johnwinans/2056-LPC546xxJyyyBD208-breakout/README.md

# 2056-LPC546xxJyyyBD208-breakout

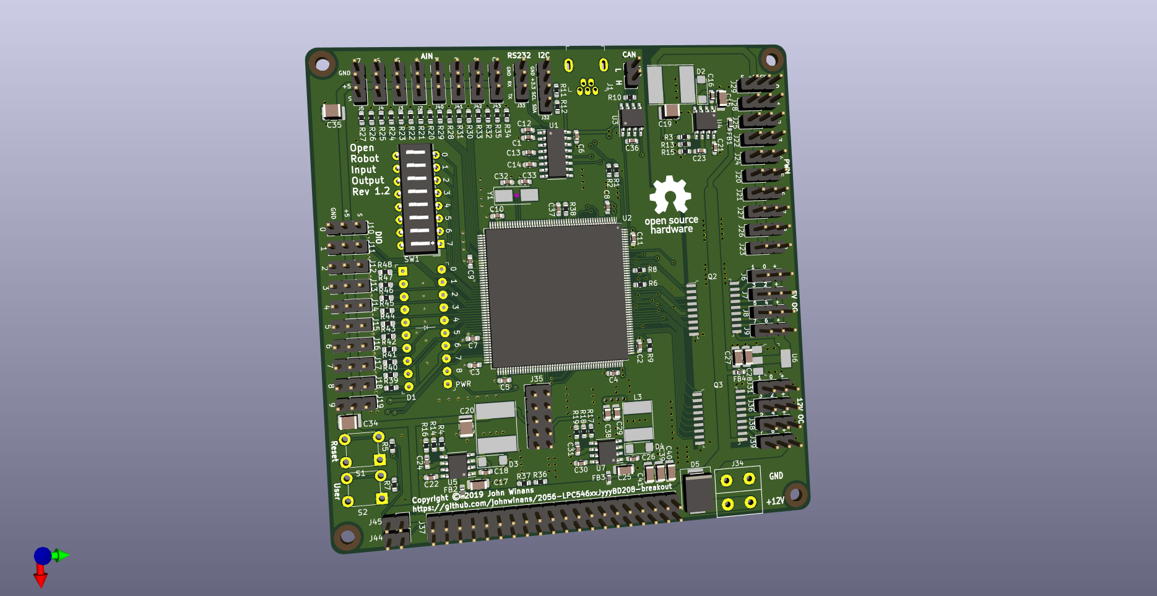
[picture p1: 2056-LPC546xxJyyyBD208-breakout.png]
Front
