johnwinans/2056-LPC546xxJyyyBD208-breakout/2056-LPC546xxJyyyBD208-breakout.pdf

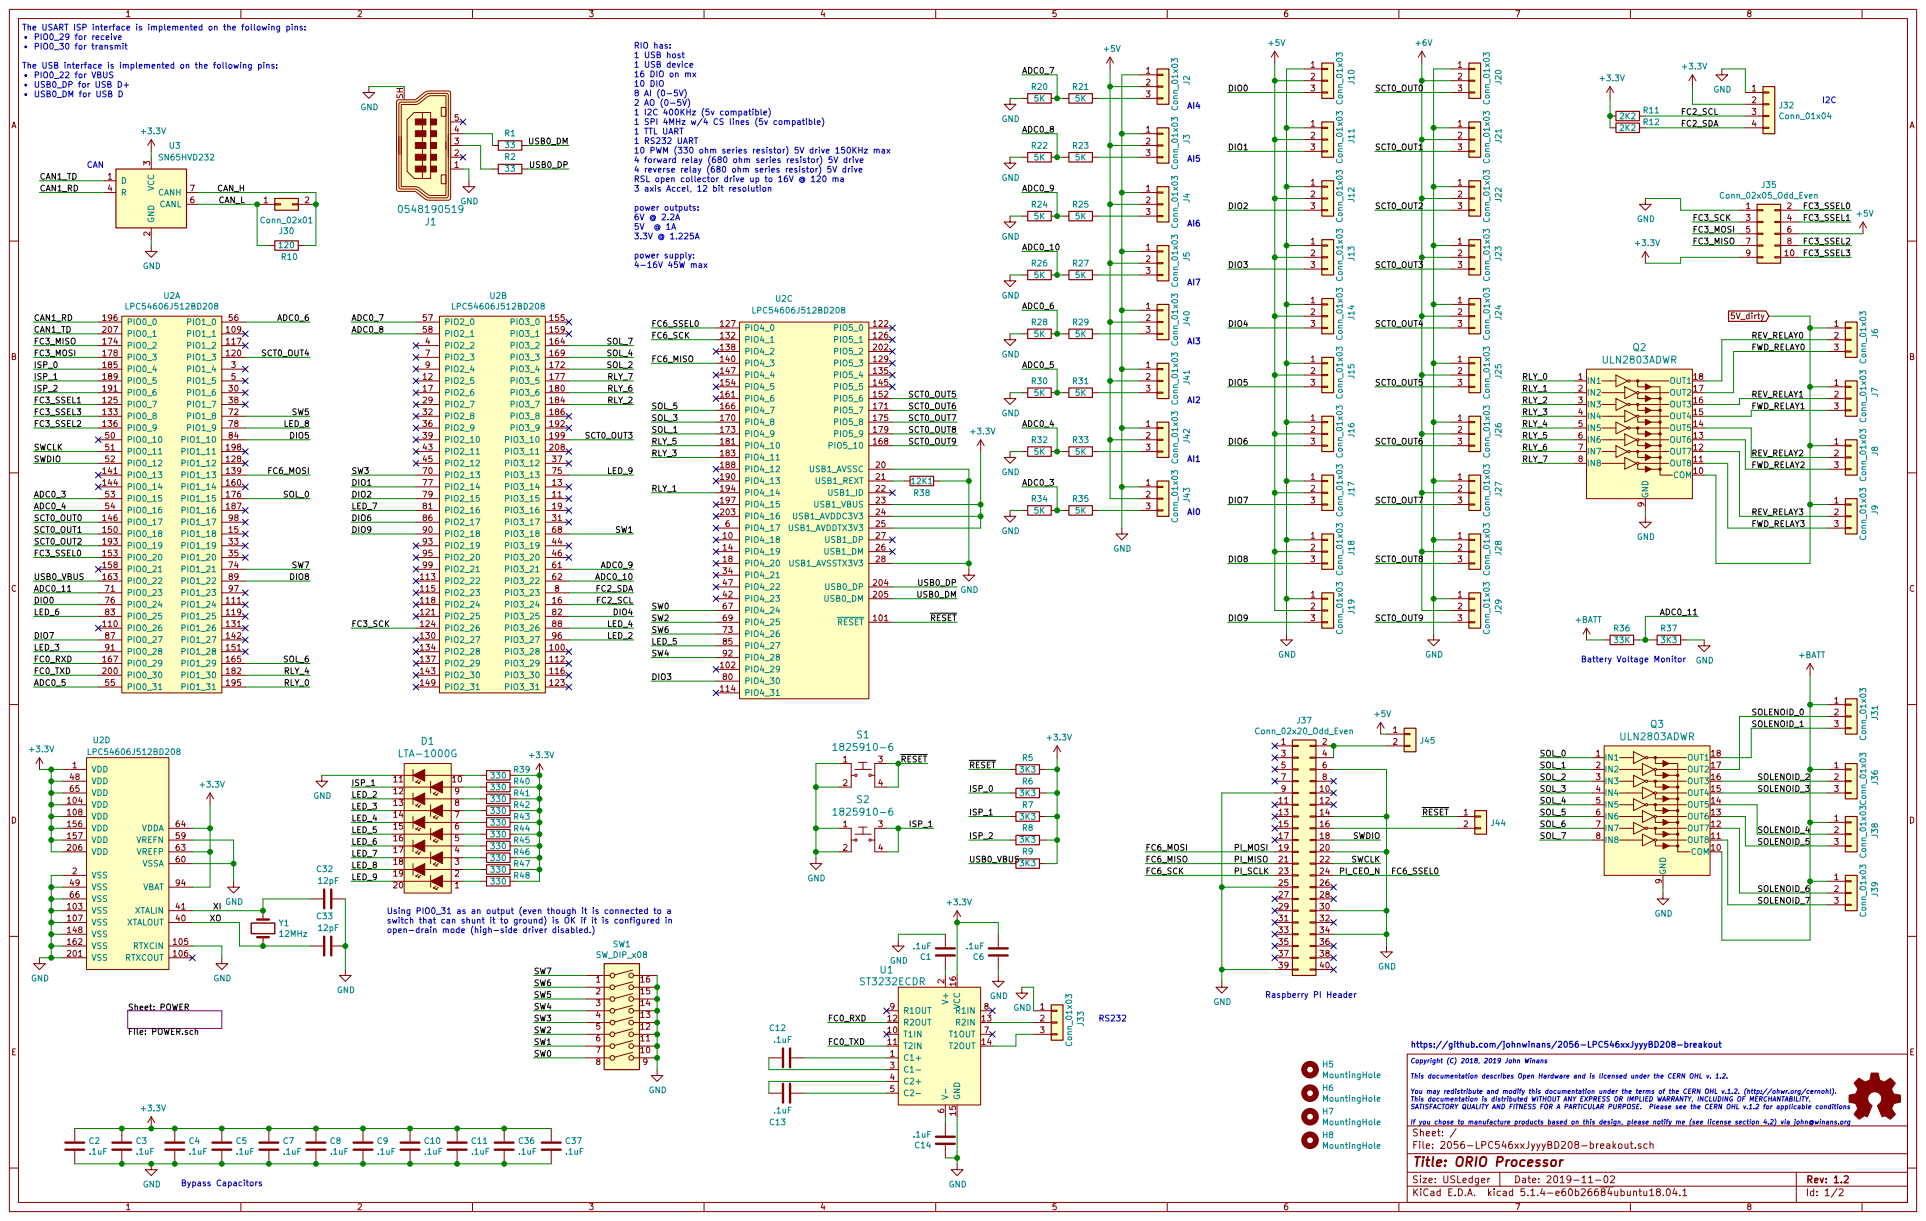
[picture p2: page 1]

The USART ISP interface is implemented on the following pins:
PIO0_29 for receive
PIO0_30 for transmit The USB interface is implemented on the following pins:

RIO has: 1 USB host 1 USB device

16 DIO on mx 10 DIO
1 I2C 400KHz (5v compatible)
1 SPI 4MHz w/4 CS lines (5v compatible) 1 TTL UART

1 RS232 UART
10 PWM (330 ohm series resistor) 5V drive 150KHz max
4 forward relay (680 ohm series resistor) 5V drive
4 reverse relay (680 ohm series resistor) 5V drive
RSL open collector drive up to 16V @ 120 ma
3 axis Accel, 12 bit resolution

Using PIO0_31 as an output (even though it is connected to a
switch that can shunt it to ground) is OK if it is configured in
open-drain mode (high-side driver disabled.)

File: 2056-LPC546xxJyyyBD208-breakout.sch Sheet: / Sheet: POWER

If you chose to manufacture products based on this design, please notify me (see license section 4.2) via john@winans.org https://github.com/johnwinans/2056-LPC546xxJyyyBD208-breakout
Copyright (C) 2018, 2019 John Winans This documentation describes Open Hardware and is licensed under the CERN OHL v. 1.2. You may redistribute and modify this documentation under the terms of the CERN OHL v.1.2. (http://ohwr.org/cernohl). This documentation is distributed WITHOUT ANY EXPRESS OR IMPLIED WARRANTY, INCLUDING OF MERCHANTABILITY, SATISFACTORY QUALITY AND FITNESS FOR A PARTICULAR PURPOSE. Please see the CERN OHL v.1.2 for applicable conditions

Id: 1/2 Title: ORIO Processor

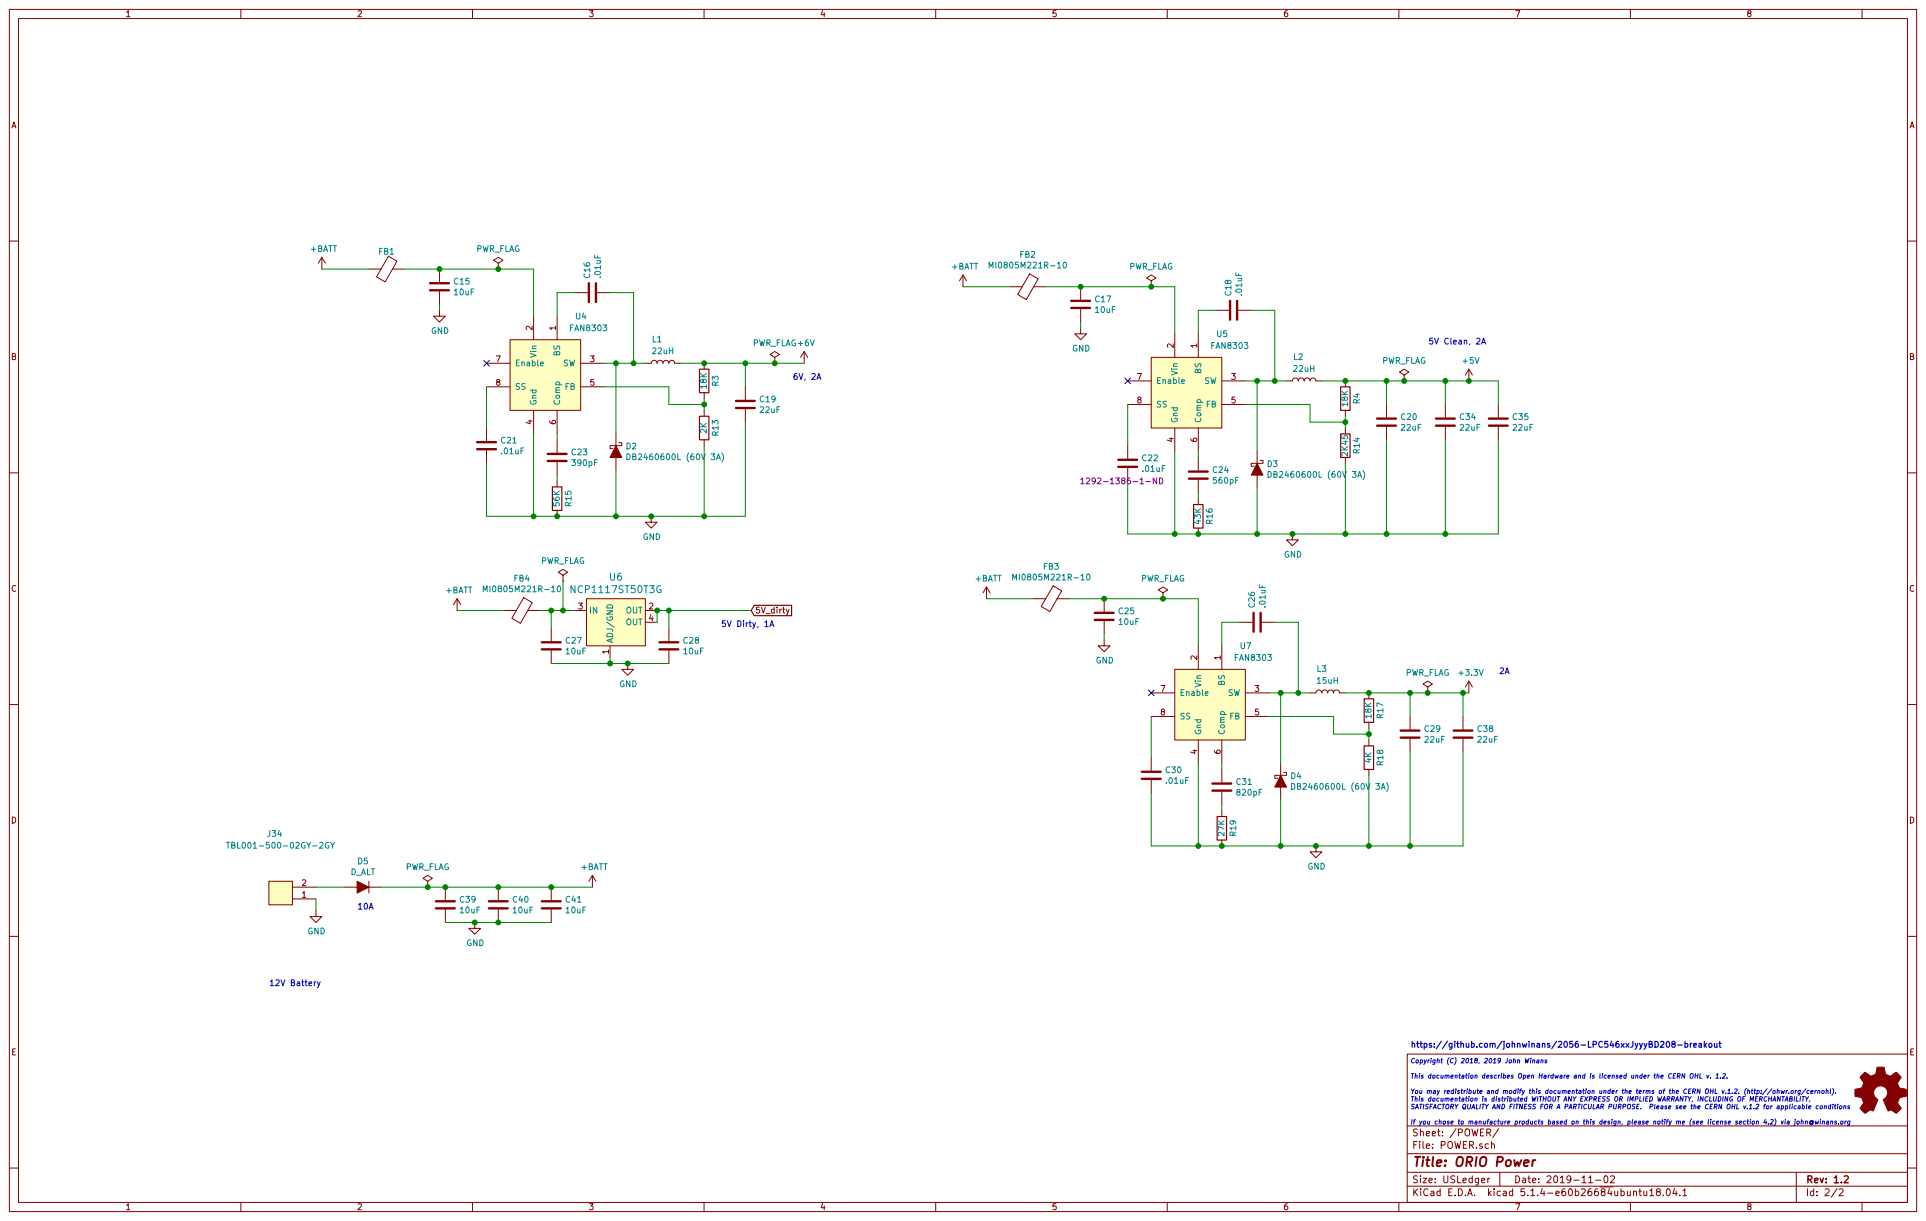
[picture p3: page 2]

If you chose to manufacture products based on this design, please notify me (see license section 4.2) via john@winans.org 10A

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

Id: 2/2 Title: ORIO Power File: POWER.sch Sheet: /POWER/
