johnwinans/2056-LPC546xxJyyyBD208-breakout/2056-LPC546xxJyyyBD208-breakout.kicad_pcb

## KiCad design 2056-LPC546xxJyyyBD208-breakout.kicad_pcb (2019-11-04)

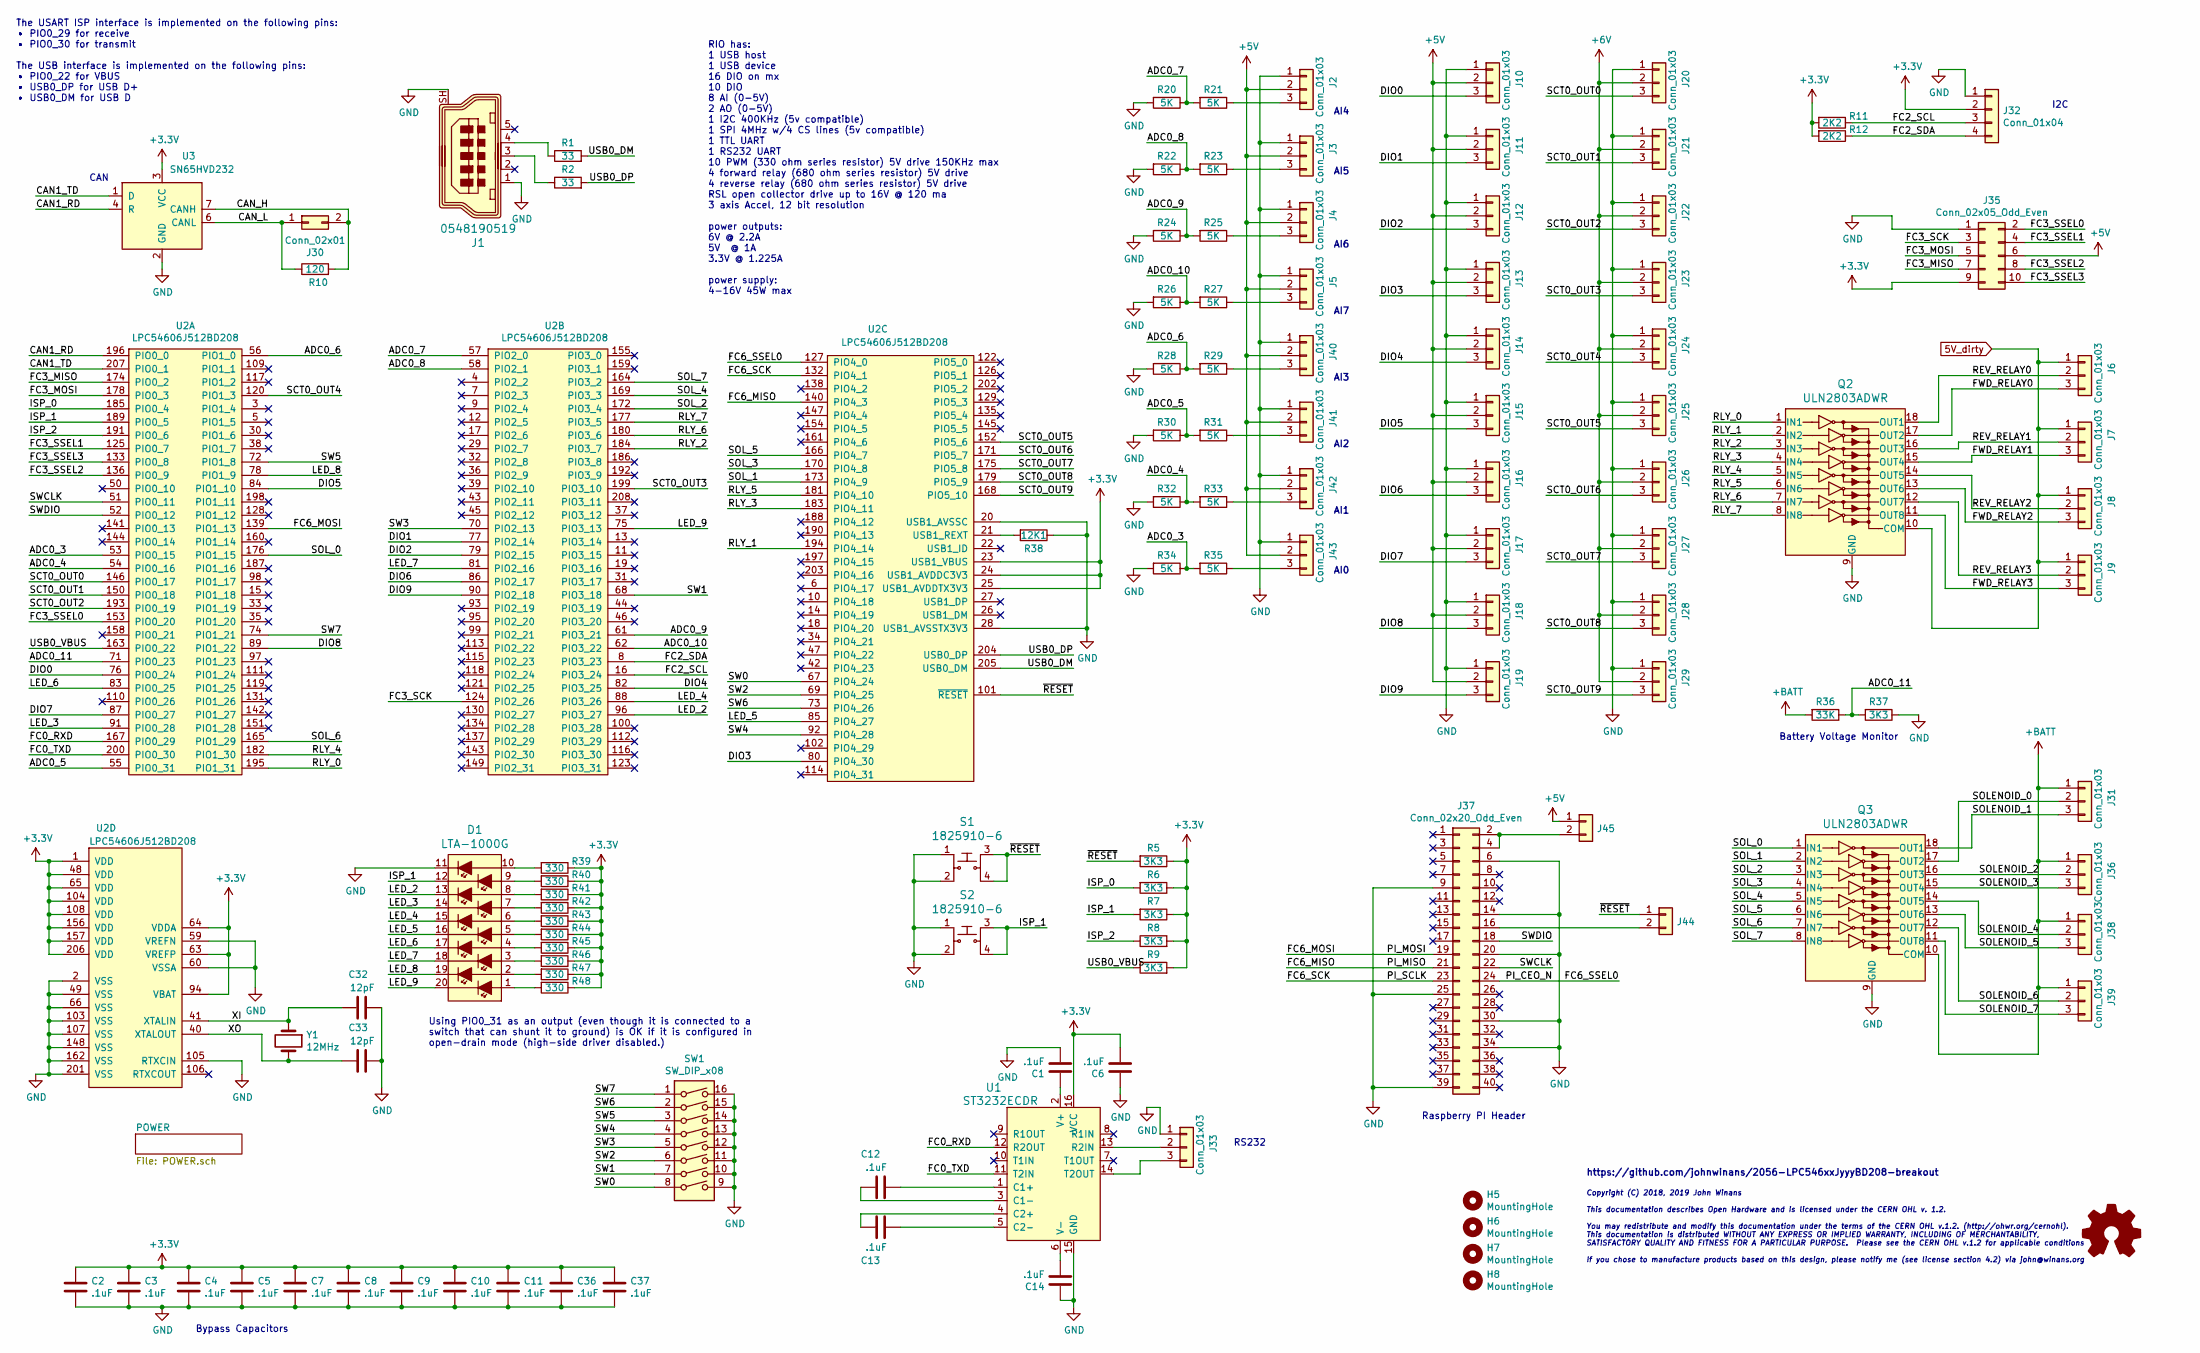
[picture p4: schematic 2056-LPC546xxJyyyBD208-breakout.sch, ORIO Processor]

Parts:
C1, C2, C3, C4, C5, C6, C7, C8, C9, C10, C11, C12, C13, C14, C36, C37: .1uF; C_0603_1608Metric_Pad1.05x0.95mm_HandSolder; Digi-Key_PN 445-6854-1-ND
C32, C33: 12pF; C_0603_1608Metric_Pad1.05x0.95mm_HandSolder; Digi-Key_PN 445-6854-1-ND
D1: LTA-1000G; LED_Bar_Graph_LTA-1000; MPN LTA-1000G; Digi-Key_PN 160-1067-ND
H5, H6, H7, H8: MountingHole; MountingHole_2.7mm_M2.5
J1: 0548190519; USB_Mini_B_Female_548190519; MPN 0548190519; Digi-Key_PN WM17115-ND
J2, J3, J4, J5, J6, J7, J8, J9, J10, J11, J12, J13, J14, J15, J16, J17, J18, J19, J20, J21, J22, J23, J24, J25, J26, J27, J28, J29, J31, J33, J36, J38, J39, J40, J41, J42, J43: Conn_01x03; PinHeader_1x03_P2.54mm_Vertical; Digi-Key_PN 2057-PH1-03-UA-ND
J30: Conn_02x01; PinHeader_1x02_P2.54mm_Vertical; Digi-Key_PN 2057-PH1-02-UA-ND
J32: Conn_01x04; PinHeader_1x04_P2.54mm_Vertical; Digi-Key_PN 2057-PH1-04-UA-ND
J35: Conn_02x05_Odd_Even; PinHeader_2x05_P2.54mm_Vertical
J37: Conn_02x20_Odd_Even; PinHeader_2x20_P2.54mm_Vertical; Digi-Key_PN PH2-20-UA
J44, J45: Conn_01x02; PinHeader_1x02_P2.54mm_Vertical
LOGO1: Logo_Open_Hardware_Small; OSHW-Logo_11.4x12mm_SilkScreen
Q2, Q3: ULN2803ADWR; SOIC-18_W7.5mm; MPN ULN2803ADWR; Digi-Key_PN 296-15777-1-ND
R1, R2: 33; R_0603_1608Metric_Pad1.05x0.95mm_HandSolder; Digi-Key_PN 311-33.0HRCT-ND
R5, R6, R7, R8, R9, R37: 3K3; R_0603_1608Metric_Pad1.05x0.95mm_HandSolder; Digi-Key_PN 311-3.30KHRCT-ND
R10: 120; R_0603_1608Metric_Pad1.05x0.95mm_HandSolder; Digi-Key_PN 311-120HRCT-ND
R11, R12: 2K2; R_0603_1608Metric_Pad1.05x0.95mm_HandSolder; Digi-Key_PN 311-2.20KHRCT-ND
R20, R21, R22, R23, R24, R25, R26, R27, R28, R29, R30, R31, R32, R33, R34, R35: 5K; R_0603_1608Metric_Pad1.05x0.95mm_HandSolder
R36: 33K; R_0603_1608Metric_Pad1.05x0.95mm_HandSolder; Digi-Key_PN 311-33.0KHRCT-ND
R38: 12K1; R_0603_1608Metric_Pad1.05x0.95mm_HandSolder; Digi-Key_PN 311-12.1KHRCT-ND
R39, R40, R41, R42, R43, R44, R45, R46, R47, R48: 330; R_0603_1608Metric_Pad1.05x0.95mm_HandSolder
S1, S2: 1825910-6; Switch_Tactile_THT_6x6mm; MPN 1825910-6; Digi-Key_PN 450-1650-ND
SW1: SW_DIP_x08; SW_DIP_SPSTx08_Slide_6.7x21.88mm_W7.62mm_P2.54mm_LowProfile; Digi-Key_PN CT2108MS-ND
U1: ST3232ECDR; SOIC-16_3.9x9.9mm_P1.27mm; MPN ST3232ECDR; Digi-Key_PN 497-6537-1-ND
U2: LPC54606J512BD208; LQFP-208_28x28mm_P0.5mm; Digi-Key_PN 568-13367-ND
U3: SN65HVD232; SOIC-8_3.9x4.9mm_P1.27mm; Digi-Key_PN 296-26344-1-ND
Y1: 12MHz; Crystal_SMD_5032-2Pin_5.0x3.2mm_HandSoldering; Digi-Key_PN 644-1034-1-ND

Connections:
5V_dirty: J6.1, J7.1, J8.1, J9.1, Q2.10 (COM); also elsewhere on the board
+3V3: C2.1, C3.1, C4.1, C5.1, C6.2, C7.1, C8.1, C9.1, C10.1, C11.1, C36.1, C37.1, J32.2, J35.9, R5.1, R6.1, R7.1, R8.2, R9.2, R11.2, R12.2, R39.1, R40.1, R41.1, R42.1, R43.1, R44.1, R45.1, R46.1, R47.1, R48.1, U1.16 (VCC), U2.1 (VDD), U2.23 (USB1_VBUS), U2.24 (USB1_AVDDC3V3), U2.25 (USB1_AVDDTX3V3), U2.48 (VDD), U2.63 (VREFP), U2.64 (VDDA), U2.65 (VDD), U2.94 (VBAT), U2.104 (VDD), U2.108 (VDD), U2.156 (VDD), U2.157 (VDD), U2.206 (VDD), U3.3 (VCC); also elsewhere on the board
+5V: J2.2, J3.2, J4.2, J5.2, J10.2, J11.2, J12.2, J13.2, J14.2, J15.2, J16.2, J17.2, J18.2, J19.2, J35.6, J40.2, J41.2, J42.2, J43.2, J45.1; also elsewhere on the board
+6V: J20.2, J21.2, J22.2, J23.2, J24.2, J25.2, J26.2, J27.2, J28.2, J29.2; also elsewhere on the board
+BATT: J31.1, J36.1, J38.1, J39.1, Q3.10 (COM), R36.2; also elsewhere on the board
/ADC0_3: R34.1, R35.2, U2.53 (PIO0_15)
/ADC0_4: R32.1, R33.2, U2.54 (PIO0_16)
/ADC0_5: R30.1, R31.2, U2.55 (PIO0_31)
/ADC0_6: R28.1, R29.2, U2.56 (PIO1_0)
/ADC0_7: R20.1, R21.2, U2.57 (PIO2_0)
/ADC0_8: R22.1, R23.2, U2.58 (PIO2_1)
/ADC0_9: R24.1, R25.2, U2.61 (PIO3_21)
/ADC0_10: R26.1, R27.2, U2.62 (PIO3_22)
/ADC0_11: R36.1, R37.2, U2.71 (PIO0_23)
/CAN1_RD: U2.196 (PIO0_0), U3.4 (R)
/CAN1_TD: U2.207 (PIO0_1), U3.1 (D)
/CAN_H: J30.2, R10.2, U3.7 (CANH)
/CAN_L: J30.1, R10.1, U3.6 (CANL)
/DIO0: J10.3, U2.76 (PIO0_24)
/DIO1: J11.3, U2.77 (PIO2_14)
/DIO2: J12.3, U2.79 (PIO2_15)
/DIO3: J13.3, U2.80 (PIO4_30)
/DIO4: J14.3, U2.82 (PIO3_25)
/DIO5: J15.3, U2.84 (PIO1_10)
/DIO6: J16.3, U2.86 (PIO2_17)
/DIO7: J17.3, U2.87 (PIO0_27)
/DIO8: J18.3, U2.89 (PIO1_22)
/DIO9: J19.3, U2.90 (PIO2_18)
/FC0_RXD: U1.12 (R2OUT), U2.167 (PIO0_29)
/FC0_TXD: U1.11 (T2IN), U2.200 (PIO0_30)
/FC2_SCL: J32.3, R11.1, U2.16 (PIO3_24)
/FC2_SDA: J32.4, R12.1, U2.8 (PIO3_23)
/FC3_MISO: J35.7, U2.174 (PIO0_2)
/FC3_MOSI: J35.5, U2.178 (PIO0_3)
/FC3_SCK: J35.3, U2.124 (PIO2_26)
/FC3_SSEL0: J35.2, U2.153 (PIO0_20)
/FC3_SSEL1: J35.4, U2.125 (PIO0_7)
/FC3_SSEL2: J35.8, U2.136 (PIO0_9)
/FC3_SSEL3: J35.10, U2.133 (PIO0_8)
/FC6_MISO: J37.21, U2.140 (PIO4_3)
/FC6_MOSI: J37.19, U2.139 (PIO1_13)
/FC6_SCK: J37.23, U2.132 (PIO4_1)
/FC6_SSEL0: J37.24, U2.127 (PIO4_0)
/FWD_RELAY0: J6.3, Q2.17 (OUT2)
/FWD_RELAY1: J7.3, Q2.15 (OUT4)
/FWD_RELAY2: J8.3, Q2.13 (OUT6)
/FWD_RELAY3: J9.3, Q2.11 (OUT8)
/ISP_0: R6.2, U2.185 (PIO0_4)
/ISP_1: D1.12, R7.2, S2.3, S2.4, U2.189 (PIO0_5)
/ISP_2: R8.1, U2.191 (PIO0_6)
/LED_2: D1.13, U2.96 (PIO3_27)
/LED_3: D1.14, U2.91 (PIO0_28)
/LED_4: D1.15, U2.88 (PIO3_26)
/LED_5: D1.16, U2.85 (PIO4_27)
/LED_6: D1.17, U2.83 (PIO0_25)
/LED_7: D1.18, U2.81 (PIO2_16)
/LED_8: D1.19, U2.78 (PIO1_9)
/LED_9: D1.20, U2.75 (PIO3_13)
/REV_RELAY0: J6.2, Q2.18 (OUT1)
/REV_RELAY1: J7.2, Q2.16 (OUT3)
/REV_RELAY2: J8.2, Q2.14 (OUT5)
/REV_RELAY3: J9.2, Q2.12 (OUT7)
/RLY_0: Q2.1 (IN1), U2.195 (PIO1_31)
/RLY_1: Q2.2 (IN2), U2.194 (PIO4_14)
/RLY_2: Q2.3 (IN3), U2.184 (PIO3_7)
/RLY_3: Q2.4 (IN4), U2.183 (PIO4_11)
/RLY_4: Q2.5 (IN5), U2.182 (PIO1_30)
/RLY_5: Q2.6 (IN6), U2.181 (PIO4_10)
/RLY_6: Q2.7 (IN7), U2.180 (PIO3_6)
/RLY_7: Q2.8 (IN8), U2.177 (PIO3_5)
/SCT0_OUT0: J20.3, U2.146 (PIO0_17)
/SCT0_OUT1: J21.3, U2.150 (PIO0_18)
/SCT0_OUT2: J22.3, U2.193 (PIO0_19)
/SCT0_OUT3: J23.3, U2.199 (PIO3_10)
/SCT0_OUT4: J24.3, U2.120 (PIO1_3)
/SCT0_OUT5: J25.3, U2.152 (PIO5_6)
/SCT0_OUT6: J26.3, U2.171 (PIO5_7)
/SCT0_OUT7: J27.3, U2.175 (PIO5_8)
/SCT0_OUT8: J28.3, U2.179 (PIO5_9)
/SCT0_OUT9: J29.3, U2.168 (PIO5_10)
/SOLENOID_0: J31.2, Q3.17 (OUT2)
/SOLENOID_1: J31.3, Q3.18 (OUT1)
/SOLENOID_2: J36.2, Q3.16 (OUT3)
/SOLENOID_3: J36.3, Q3.15 (OUT4)
/SOLENOID_4: J38.2, Q3.14 (OUT5)
/SOLENOID_5: J38.3, Q3.13 (OUT6)
/SOLENOID_6: J39.2, Q3.12 (OUT7)
/SOLENOID_7: J39.3, Q3.11 (OUT8)
/SOL_0: Q3.1 (IN1), U2.176 (PIO1_15)
/SOL_1: Q3.2 (IN2), U2.173 (PIO4_9)
/SOL_2: Q3.3 (IN3), U2.172 (PIO3_4)
/SOL_3: Q3.4 (IN4), U2.170 (PIO4_8)
/SOL_4: Q3.5 (IN5), U2.169 (PIO3_3)
/SOL_5: Q3.6 (IN6), U2.166 (PIO4_7)
/SOL_6: Q3.7 (IN7), U2.165 (PIO1_29)
/SOL_7: Q3.8 (IN8), U2.164 (PIO3_2)
/SW0: SW1.8, U2.67 (PIO4_24)
/SW1: SW1.7, U2.68 (PIO3_18)
/SW2: SW1.6, U2.69 (PIO4_25)
/SW3: SW1.5, U2.70 (PIO2_13)
/SW4: SW1.4, U2.92 (PIO4_28)
/SW5: SW1.3, U2.72 (PIO1_8)
/SW6: SW1.2, U2.73 (PIO4_26)
/SW7: SW1.1, U2.74 (PIO1_21)
/SWCLK: J37.22, U2.51 (PIO0_11)
/SWDIO: J37.18, U2.52 (PIO0_12)
/USB0_DM: R1.2, U2.205 (USB0_DM)
/USB0_DP: R2.2, U2.204 (USB0_DP)
/USB0_VBUS: R9.1, U2.163 (PIO0_22)
/XI: C32.1, U2.41 (XTALIN), Y1.1
/XO: C33.1, U2.40 (XTALOUT), Y1.2
/~RESET~: J44.1, R5.2, S1.3, S1.4, U2.101 (~RESET)
GND: C1.2, C2.2, C3.2, C4.2, C5.2, C6.1, C7.2, C8.2, C9.2, C10.2, C11.2, C14.1, C32.2, C33.2, C36.2, C37.2, D1.11, J1.1, J1.SH, J2.1, J3.1, J4.1, J5.1, J10.1, J11.1, J12.1, J13.1, J14.1, J15.1, J16.1, J17.1, J18.1, J19.1, J20.1, J21.1, J22.1, J23.1, J24.1, J25.1, J26.1, J27.1, J28.1, J29.1, J32.1, J33.1, J35.1, J37.6, J37.9, J37.14, J37.20, J37.25, J37.30, J37.34, J37.39, J40.1, J41.1, J42.1, J43.1, Q2.9 (GND), Q3.9 (GND), R20.2, R22.2, R24.2, R26.2, R28.2, R30.2, R32.2, R34.2, R37.1, R38.1, S1.1, S1.2, S2.1, S2.2, SW1.9, SW1.10, SW1.11, SW1.12, SW1.13, SW1.14, SW1.15, SW1.16, U1.15 (GND), U2.2 (VSS), U2.20 (USB1_AVSSC), U2.28 (USB1_AVSSTX3V3), U2.49 (VSS), U2.59 (VREFN), U2.60 (VSSA), U2.66 (VSS), U2.103 (VSS), U2.105 (RTXCIN), U2.107 (VSS), U2.148 (VSS), U2.162 (VSS), U2.201 (VSS), U3.2 (GND); also elsewhere on the board
unnamed: C1.1, U1.2 (V+)
unnamed: C12.1, U1.3 (C1-)
unnamed: C12.2, U1.1 (C1+)
unnamed: C13.1, U1.4 (C2+)
unnamed: C13.2, U1.5 (C2-)
unnamed: C14.2, U1.6 (V-)
unnamed: D1.1, R48.2
unnamed: D1.2, R47.2
unnamed: D1.3, R46.2
unnamed: D1.4, R45.2
unnamed: D1.5, R44.2
unnamed: D1.6, R43.2
unnamed: D1.7, R42.2
unnamed: D1.8, R41.2
unnamed: D1.9, R40.2
unnamed: D1.10, R39.2
unnamed: J1.3, R2.1
unnamed: J1.4, R1.1
unnamed: J2.3, R21.1
unnamed: J3.3, R23.1
unnamed: J4.3, R25.1
unnamed: J5.3, R27.1
unnamed: J33.2, U1.13 (R2IN)
unnamed: J33.3, U1.14 (T2OUT)
unnamed: J37.2, J37.4, J45.2
unnamed: J37.16, J44.2
unnamed: J40.3, R29.1
unnamed: J41.3, R31.1
unnamed: J42.3, R33.1
unnamed: J43.3, R35.1
unnamed: R38.2, U2.21 (USB1_REXT)

Notes on the sheet:
Bypass Capacitors
Copyright (C) 2018, 2019 John Winans This documentation describes Open Hardware and is licensed under the CERN OHL v. 1.2. You may redistribute and modify this documentation under the terms of the CERN OHL v.1.2. (http://ohwr.org/cernohl). This documentation is distributed WITHOUT ANY EXPRESS OR IM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
The USART ISP interface is implemented on the following pins: • PIO0_29 for receive • PIO0_30 for transmit The USB interface is implemented on the following pins: • PIO0_22 for VBUS • USB0_DP for USB D+ • USB0_DM for USB D
https://github.com/johnwinans/2056-LPC546xxJyyyBD208-breakout
RIO has: 1 USB host 1 USB device 16 DIO on mx 10 DIO 8 AI (0-5V) 2 AO (0-5V) 1 I2C 400KHz (5v compatible) 1 SPI 4MHz w/4 CS lines (5v compatible) 1 TTL UART 1 RS232 UART 10 PWM (330 ohm series resistor) 5V drive 150KHz max 4 forward relay (680 ohm series resistor) 5V drive 4 reverse relay (680 ohm 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
I2C
CAN
Using PIO0_31 as an output (even though it is connected to a switch that can shunt it to ground) is OK if it is configured in open-drain mode (high-side driver disabled.)
Raspberry PI Header
RS232
Battery Voltage Monitor
AI0
AI1
AI2
AI3
AI7
AI6
AI5
AI4

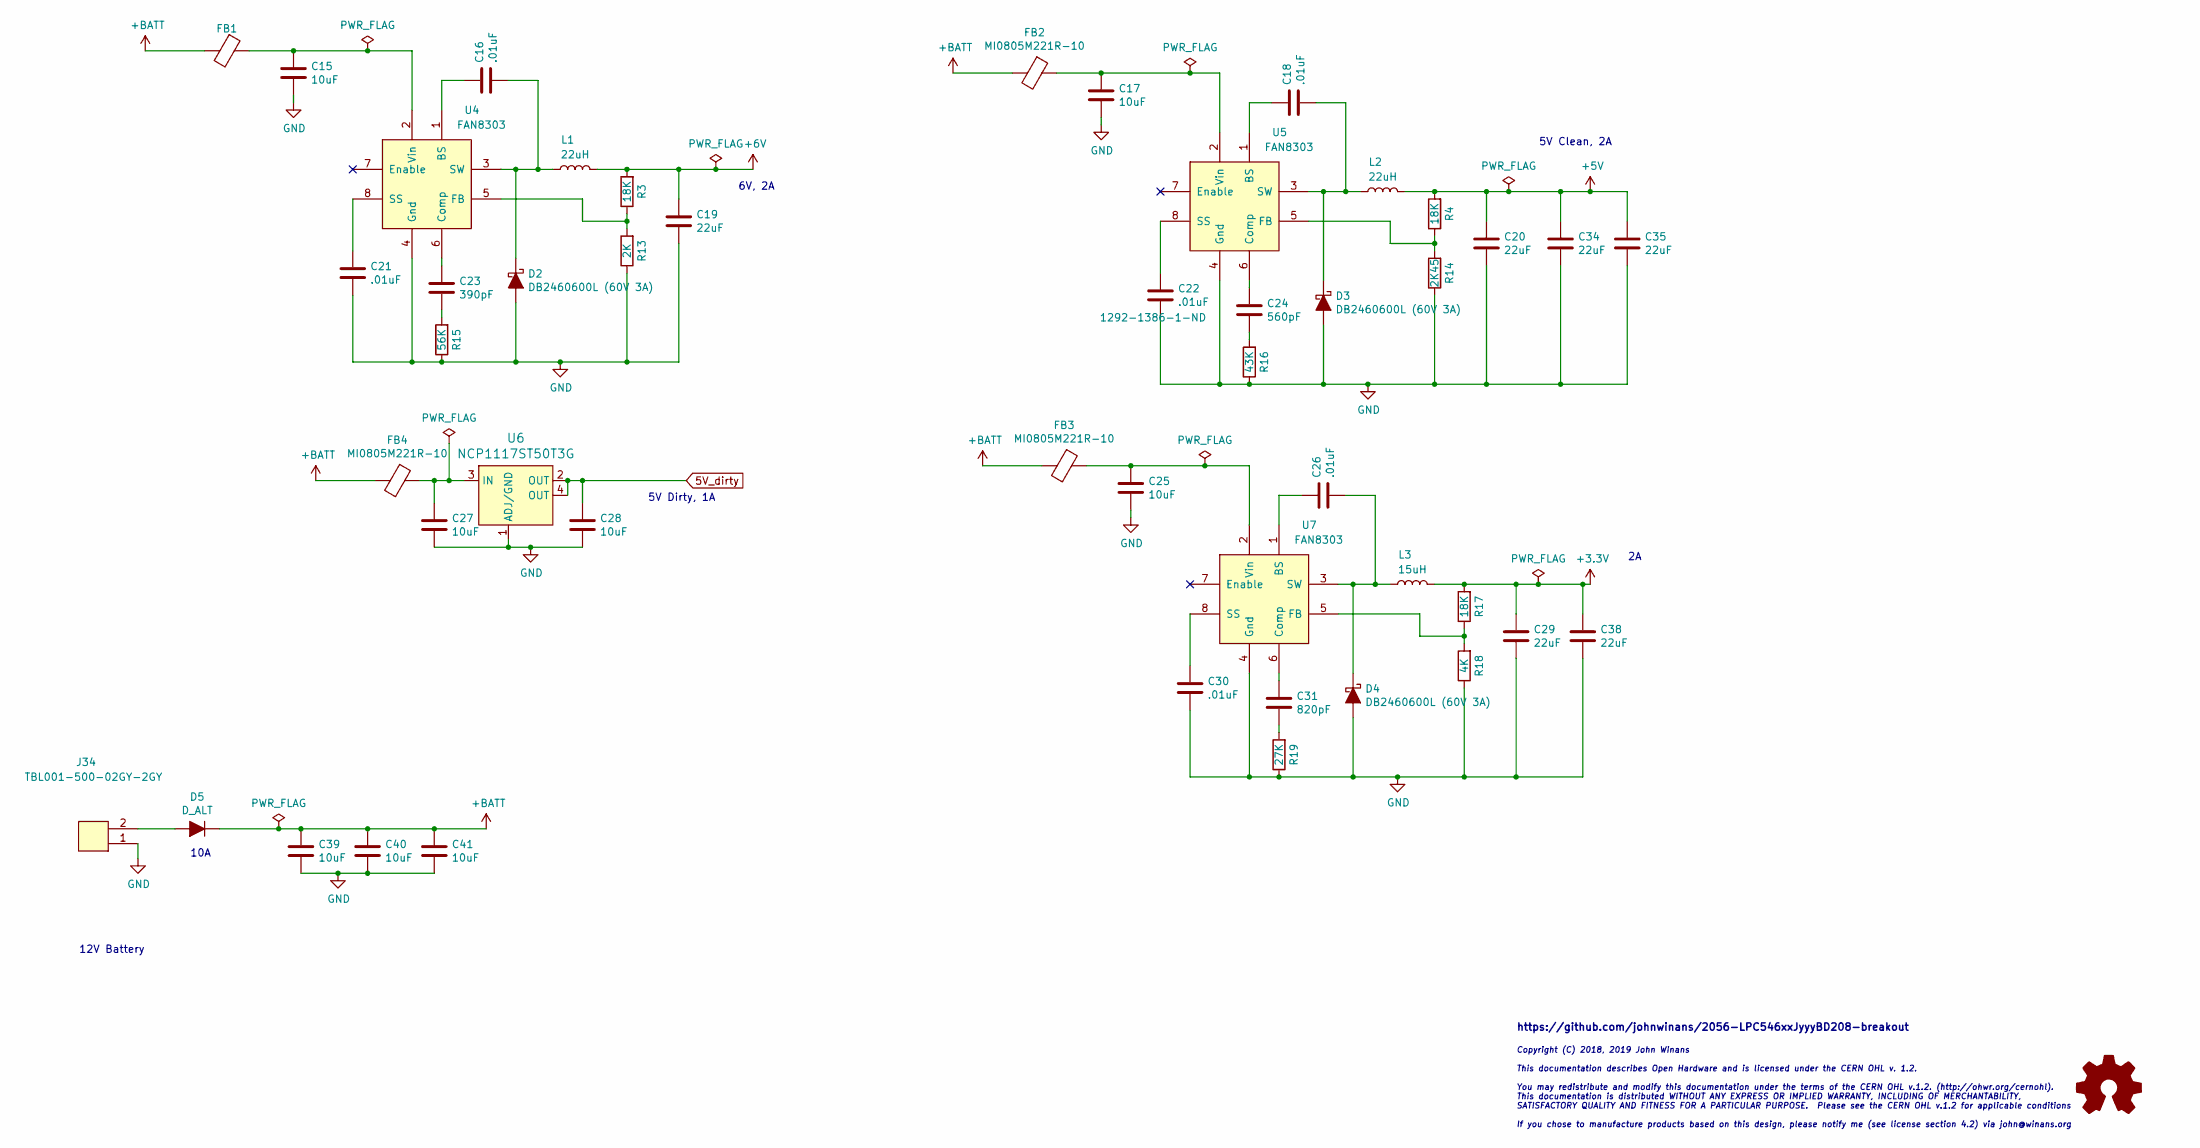
[picture p5: schematic POWER.sch, ORIO Power]

Parts:
C15, C17, C25, C27, C28, C39, C40, C41: 10uF; C_1206_3216Metric_Pad1.42x1.75mm_HandSolder; Digi-Key_PN 1276-1075-1-ND
C16, C18, C21, C22, C26, C30: .01uF; C_0603_1608Metric_Pad1.05x0.95mm_HandSolder; Digi-Key_PN 1292-1386-1-ND
C19, C20, C34, C35: 22uF; C_1210_3225Metric_Pad1.42x2.65mm_HandSolder; Digi-Key_PN 1276-6780-1-ND
C23: 390pF; C_0603_1608Metric_Pad1.05x0.95mm_HandSolder; Digi-Key_PN 1276-2049-1-ND
C24: 560pF; C_0603_1608Metric_Pad1.05x0.95mm_HandSolder; Digi-Key_PN 1276-1278-1-ND
C29, C38: 22uF; C_0805_2012Metric_Pad1.15x1.40mm_HandSolder; Digi-Key_PN 1276-6780-1-ND
C31: 820pF; C_0603_1608Metric_Pad1.05x0.95mm_HandSolder; Digi-Key_PN 1276-2117-1-ND
D2, D3, D4: DB2460600L (60V 3A); D_1806_4516Metric_Pad1.57x1.80mm_HandSolder; Digi-Key_PN DB2460600LCT-ND
D5: D_ALT; D_SMC; Digi-Key_PN S10KCV7GCT-ND
FB1, FB2, FB3, FB4: MI0805M221R-10; L_0603_1608Metric_Pad1.05x0.95mm_HandSolder; Digi-Key_PN 240-2392-1-ND
J34: TBL001-500-02GY-2GY; Digi-Key_PN 102-6360-ND
L1, L2: 22uH; L_Taiyo-Yuden_NR-80xx_HandSoldering; MPN NR8040T220M; Digi-Key_PN 587-2002-1-ND
L3: 15uH; L_Taiyo-Yuden_NR-60xx_HandSoldering; Digi-Key_PN 587-2633-1-ND
R3, R4, R17: 18K; R_0603_1608Metric_Pad1.05x0.95mm_HandSolder; Digi-Key_PN 311-18.0KHRCT-ND
R13: 2K; R_0603_1608Metric_Pad1.05x0.95mm_HandSolder
R14: 2K45; R_0603_1608Metric_Pad1.05x0.95mm_HandSolder; Digi-Key_PN 311-2.43KHRCT-ND
R15: 56K; R_0603_1608Metric_Pad1.05x0.95mm_HandSolder; Digi-Key_PN CR0603-JW-563ELFCT-ND
R16: 43K; R_0603_1608Metric_Pad1.05x0.95mm_HandSolder; Digi-Key_PN 311-43.0KHRCT-ND
R18: 4K; R_0603_1608Metric_Pad1.05x0.95mm_HandSolder; Digi-Key_PN 311-4.02KHRCT-ND
R19: 27K; R_0603_1608Metric_Pad1.05x0.95mm_HandSolder; Digi-Key_PN 311-27.0KHRCT-ND
U4, U5, U7: FAN8303; SOIC-8_3.9x4.9mm_P1.27mm; Digi-Key_PN FAN8303MXCT-ND
U6: NCP1117ST50T3G; SOT-223; MPN NCP1117ST50T3G; Digi-Key_PN NCP1117ST50T3GOSCT-ND

Connections:
5V_dirty: C28.1, U6.2 (OUT), U6.4 (OUT); also elsewhere on the board
+3V3: C29.1, C38.1, L3.2, R17.2; also elsewhere on the board
+5V: C20.1, C34.1, C35.1, L2.2, R4.2; also elsewhere on the board
+6V: C19.1, L1.2, R3.2; also elsewhere on the board
+BATT: C39.1, C40.1, C41.1, D5.1 (K), FB1.2, FB2.2, FB3.2, FB4.2; also elsewhere on the board
GND: C15.2, C17.2, C19.2, C20.2, C21.2, C22.2, C25.2, C27.2, C28.2, C29.2, C30.2, C34.2, C35.2, C38.2, C39.2, C40.2, C41.2, D2.2 (A), D3.2 (A), D4.2 (A), J34.1, R13.1, R14.1, R15.1, R16.1, R18.1, R19.1, U4.4 (Gnd), U5.4 (Gnd), U6.1 (ADJ/GND), U7.4 (Gnd); also elsewhere on the board
unnamed: C15.1, FB1.1, U4.2 (Vin)
unnamed: C16.1, U4.1 (BS)
unnamed: C16.2, D2.1 (K), L1.1, U4.3 (SW)
unnamed: C17.1, FB2.1, U5.2 (Vin)
unnamed: C18.1, U5.1 (BS)
unnamed: C18.2, D3.1 (K), L2.1, U5.3 (SW)
unnamed: C21.1, U4.8 (SS)
unnamed: C22.1, U5.8 (SS)
unnamed: C23.1, U4.6 (Comp)
unnamed: C23.2, R15.2
unnamed: C24.1, U5.6 (Comp)
unnamed: C24.2, R16.2
unnamed: C25.1, FB3.1, U7.2 (Vin)
unnamed: C26.1, U7.1 (BS)
unnamed: C26.2, D4.1 (K), L3.1, U7.3 (SW)
unnamed: C27.1, FB4.1, U6.3 (IN)
unnamed: C30.1, U7.8 (SS)
unnamed: C31.1, U7.6 (Comp)
unnamed: C31.2, R19.2
unnamed: D5.2 (A), J34.2
unnamed: R3.1, R13.2, U4.5 (FB)
unnamed: R4.1, R14.2, U5.5 (FB)
unnamed: R17.1, R18.2, U7.5 (FB)

Notes on the sheet:
5V Clean, 2A
6V, 2A
5V Dirty, 1A
Copyright (C) 2018, 2019 John Winans This documentation describes Open Hardware and is licensed under the CERN OHL v. 1.2. You may redistribute and modify this documentation under the terms of the CERN OHL v.1.2. (http://ohwr.org/cernohl). This documentation is distributed WITHOUT ANY EXPRESS OR IM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
https://github.com/johnwinans/2056-LPC546xxJyyyBD208-breakout
12V Battery
10A

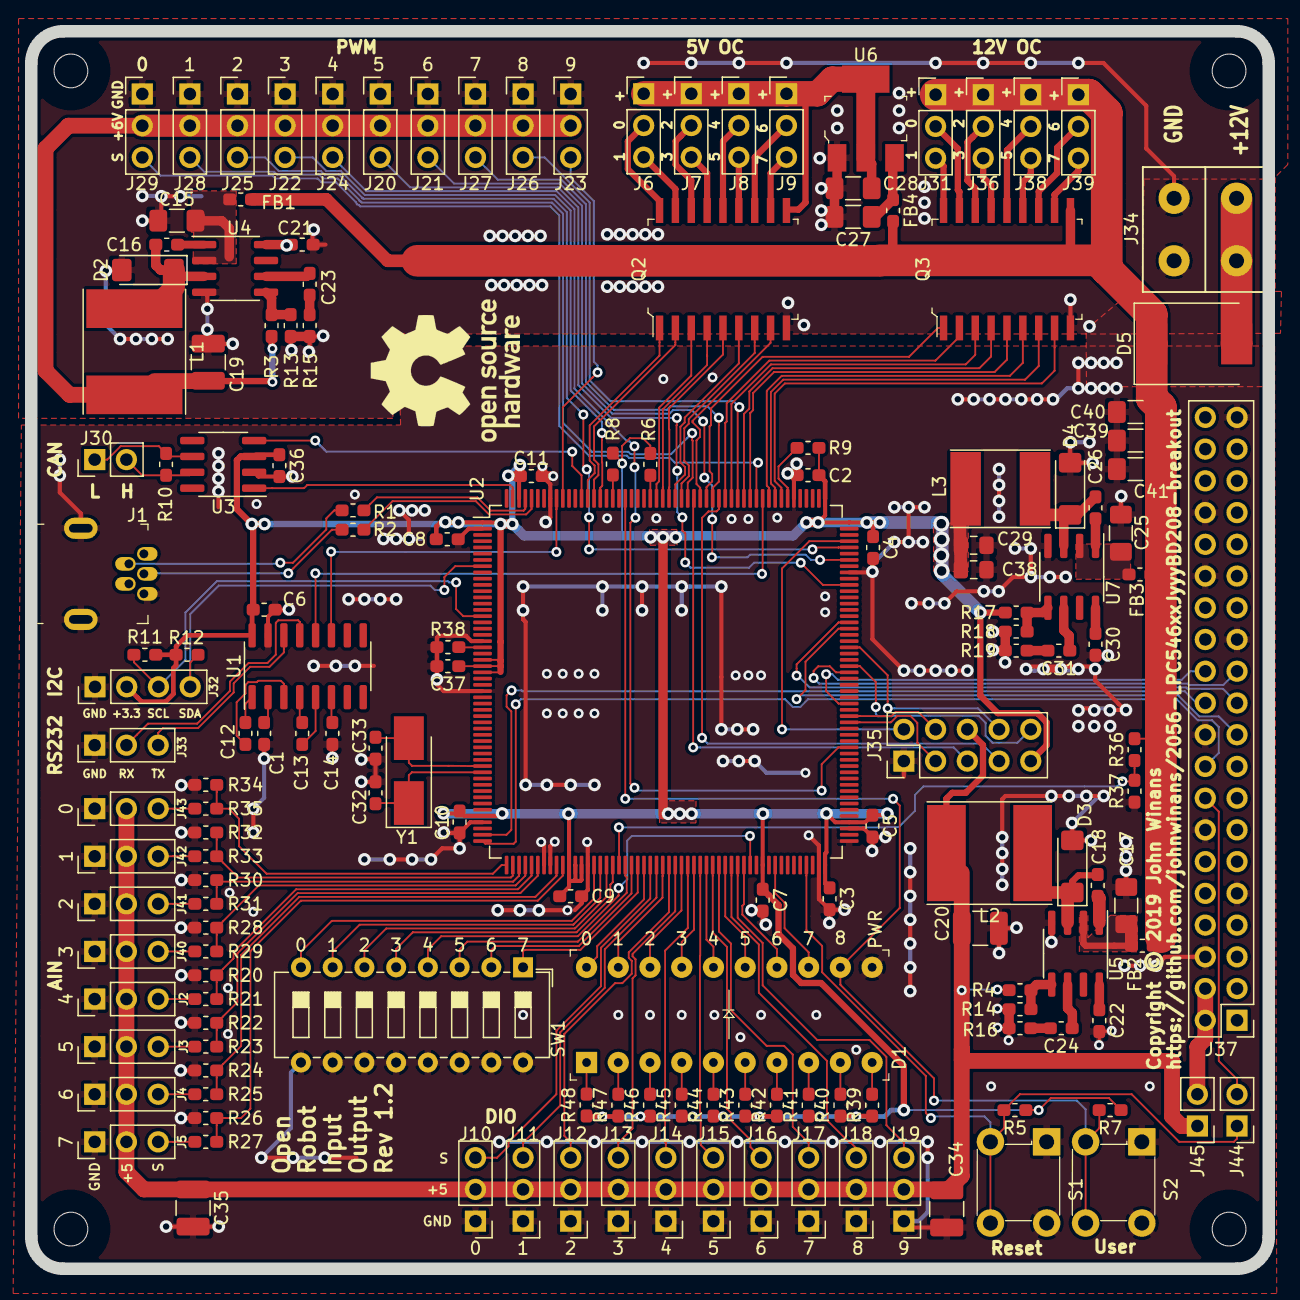
[picture p6: board 2056-LPC546xxJyyyBD208-breakout.kicad_pcb from above]

Board: 2 copper layers, 99.1 x 99.1 mm, 164 parts (0 on the bottom side), 167 nets.
