johnwinans/2056-LPC546xxJyyyBD208-breakout/(commit log)

2019-10-06 First draft of the ORIO board.
    [2056-LPC546xxJyyyBD208-breakout.kicad_pcb, 2056-LPC546xxJyyyBD208-breakout.sch, POWER.sch]
2019-10-07 Cosmetic silkscreen & title block cleanup.
    [2056-LPC546xxJyyyBD208-breakout.kicad_pcb, 2056-LPC546xxJyyyBD208-breakout.sch, POWER.sch]
2019-10-11 Rev 1.1 first manufacturable draft.
    [2056-LPC546xxJyyyBD208-breakout.kicad_pcb, 2056-LPC546xxJyyyBD208-breakout.sch, POWER.sch]
2019-10-25 Correct CPU AVSSC pin.
    [2056-LPC546xxJyyyBD208-breakout.kicad_pcb, 2056-LPC546xxJyyyBD208-breakout.sch]
2019-11-04 Fixed power on VSSC pin, add filter caps, power & reset jumpers, SWD.
    [2056-LPC546xxJyyyBD208-breakout-B_Cu.gbl, 2056-LPC546xxJyyyBD208-breakout-B_Mask.gbs, 2056-LPC546xxJyyyBD208-breakout-B_Paste.gbp, 2056-LPC546xxJyyyBD208-breakout-B_SilkS.gbo, 2056-LPC546xxJyyyBD208-breakout-Edge_Cuts.gm1, 2056-LPC546xxJyyyBD208-breakout-F_Cu.gtl, 2056-LPC546xxJyyyBD208-breakout-F_Mask.gts, 2056-LPC546xxJyyyBD208-breakout-F_Paste.gtp]
