johnwinans/2056-LPC546xxJyyyBD208-breakout/(notices)

Notices in the files:
2056-LPC546xxJyyyBD208-breakout.kicad_pcb:
Copyright © 2019 John Winans
